fermiums22/LoadingStandBOR0394000/README.md

[README_.md](https://github.com/user-attachments/files/28829557/README_.md)
# LoadingStandBOR0394000

Контроллер нагрузочного стенда для управления магнитопорошковым тормозом на базе STM32G071RB.

* MCU: STM32G071RB
* Board: NUCLEO-G071RB
* IDE: STM32CubeIDE
* Configurator: STM32CubeMX
* Language: C

---

# System requirements

## Hardware

* NUCLEO-G071RB
* Силовая плата BDC-0320-Powerboard 33
* Магнитопорошковый тормоз SKISIA PB-5
* USB кабель для ST-Link
* ПК с STM32CubeIDE

## Software

* STM32CubeIDE
* STM32CubeMX
* ST-Link Utility (опционально)
* Терминал UART (Putty, TeraTerm, RealTerm и т.д.)

---

# Описание проекта

Проект предназначен для управления магнитопорошковым тормозом нагрузочного стенда.

Основной режим работы — регулирование тока тормоза по обратной связи от датчика тока ACS724.

Пользователь задает требуемый ток через UART-консоль, после чего PI-регулятор автоматически подбирает коэффициент заполнения ШИМ для поддержания заданного значения.

Частота контура регулирования составляет 10 кГц.

---

# Основные возможности

* Регулирование тока тормоза
* Ручное управление PWM
* PI-регулятор
* Настройка коэффициентов PI через терминал
* Калибровка нуля датчика тока
* Потоковая телеметрия
* Ограничение максимального тока
* Ограничение максимального PWM
* Самодиагностика ADC через VREFINT
* Двухпортовая UART-консоль с историей команд

---

# Используемое оборудование

## Магнитопорошковый тормоз

Модель:

* SKISIA PB-5

Параметры:

| Параметр | Значение |
| --- | --- |
| Напряжение | 24 В |
| Ток | 2.15 А |
| Мощность | 51.5 Вт  |

---

## Датчик тока

Для измерения тока используется:

* ACS724KMATR-12AB-T

Измеренный ток используется как обратная связь PI-регулятора.

---

## Силовая часть

Основные компоненты силовой платы:

### Драйвер затвора

* UCC23313

### Силовой транзистор

* WSPW20N60C3 (SiC MOSFET)

### Датчик тока

* ACS724KMATR-12AB-T

---

# Архитектура системы

Силовая часть включена низковольтным ключом по минусу. Датчик тока стоит в
силовой цепи последовательно с катушкой, поэтому он измеряет реальный ток всей
петли: длинные провода, катушка и сам датчик находятся внутри одного
непрерывного токового контура.

```text
+24V ──[провод]── Катушка ──[провод]── Датчик тока ── Y ──[MOSFET]── GND
  ▲                                                        │
  └────────────────────── D_fw (Y -> +24V) ────────────────┘
```

```text
Уставка тока
      │
      ▼
PI-регулятор 10 кГц
      │
      ▼
TIM2 PWM
      │
      ├── PA5 -> UCC23313 -> MOSFET
      │
      └── PA1 -> зеркало PWM для осциллографа
                         │
                         ▼
+24V -> провода -> PB-5 -> провода -> ACS724 -> MOSFET -> GND
                         │
                         ▼
                    PA0 / ADC
                         │
                         └── обратная связь по току
```

Особенности силовой петли:

* Провода, катушка и датчик несут один и тот же непрерывный ток; провода тихие,
  датчик читает ток непрерывно.
* Энергия катушки возвращается через длинные провода и диод свободного хода
  `D_fw` в точку `+24V`. Из-за индуктивности проводов возможны пики на
  транзисторе, поэтому нужен аккуратный силовой монтаж и снаббер/ограничение
  перенапряжения при необходимости.

---

# Тактирование

Контроллер использует внешний кварцевый резонатор ABM3-8.000MHZ-D2Y-T,
запаянный на NUCLEO-G071RB.

MCO от ST-Link отключен. Это сделано специально: при коммутации силового
транзистора помехи раньше могли приводить к отваливанию ST-Link, а локальный HSE
кварц на плате Nucleo делает тактирование независимым от ST-Link.

## Источник тактирования

```
HSE = 8 MHz

```

Подключение:

| Вывод | Назначение  |
| ----- | --- |
| PF0 | RCC_OSC_IN  |
| PF1 | RCC_OSC_OUT |

Параметры PLL:

| Параметр | Значение |
| --- | --- |
| PLL Source | HSE |
| PLLM | 1 |
| PLLN | 16 |
| PLLR | 2 |

Расчет:

```text
8 MHz × 16 / 2 = 64 MHz

```

Итоговые частоты:

| Clock  | Value  |
| --- | --- |
| SYSCLK | 64 MHz |
| HCLK | 64 MHz |
| PCLK | 64 MHz |

---

# Подключение контроллера

Контроллер выполнен на базе платы NUCLEO-G071RB.

Питание Nucleo берется с силовой платы: на плате NUCLEO-G071RB установлена
перемычка питания `VIN`, на `VIN` приходит `+12V` с силовой платы. USB/ST-Link
используется для прошивки и отладки, но не является основным источником питания
контроллера в рабочем стенде.

Связь с силовой платой:

| Сигнал | Вывод STM32 | Назначение |
| --- | --- | --- |
| CUR | PA0 | Измерение тока ACS724 |
| PWM | PA5 | Управление силовым каскадом |
| PWM_MON| PA1 | Зеркало PWM для осциллографа|
| USART2_TX | PA2 | ST-Link VCP / отладочная консоль TX |
| USART2_RX | PA3 | ST-Link VCP / отладочная консоль RX |
| USART1_TX | PC4 | Задел под Raspberry Pi TX |
| USART1_RX | PC5 | Задел под Raspberry Pi RX |
| SWDIO  | PA13 | Отладка |
| SWCLK  | PA14 | Отладка |
| +12V | VIN | Питание Nucleo от силовой платы |
| GND | GND | Общий провод |

---

## Сигнал CUR

CUR подключен к выходу датчика тока ACS724.

Цепочка сигнала:

```
+24V -> провода -> PB-5 -> провода -> ACS724 -> MOSFET -> GND
                                │
                                ▼
                              CUR
                                │
                                ▼
                            PA0 (ADC1)

```

---

## Сигнал TORQUE / датчик момента T22

Временная макетная схема входа для датчика момента `HBM/HBK T22 50 Nm`.

Вход STM32:

| Сигнал | Вывод STM32 | Канал ADC |
| --- | --- | --- |
| TORQUE | PB1 / A3 | ADC1_IN9  |

Масштаб датчика, используемый в прошивке:

```text
T22 50 Nm voltage output: +/-5 V = +/-50 Nm
Sensor scale:              10 Nm/V
```

Питание аналоговой макетки:

```text
LD1117 OUT 3.3V -> MCP6002 pin 8
GND              -> MCP6002 pin 4

LD1117 input:   10 uF + 100 nF to GND
LD1117 output:  10 uF + 100 nF to GND
MCP6002 supply: 100 nF between pin 8 and pin 4
```

ОУ A в `MCP6002` делает опорную середину:

```text
3.3V --10k--+--10k-- GND
            |
          INA+ pin 3

OUTA pin 1 -> INA- pin 2

OUTA = about 1.65 V reference
100 nF from OUTA / 1.65 V point to GND
```

ОУ B буферизует смещенный сигнал датчика момента.
Текущая макетная схема:

```text
T22 signal --100k--+--> INB+ pin 5
                   |
                  33k
                   |
              OUTA 1.65 V

OUTB pin 7 -> INB- pin 6
OUTB pin 7 --100R-- PB1 / A3 / ADC1_IN9
```

Собранный вариант для входного диапазона около `+/-3 V`:

```text
Replace the 33k resistor from INB+ to OUTA/1.65V with 54.9k.
On the breadboard it is built as 51k + 3.9k in series.

T22 signal --100k--+--> INB+ pin 5
                   |
                 51k
                   |
                 3.9k
                   |
              OUTA 1.65 V
```

С резисторами `100k` и `54.9k` (`51k + 3.9k` последовательно):

```text
Vpb1 = (54.9 / (100 + 54.9)) * Vt22 + (100 / (100 + 54.9)) * 1.65

Vt22 = -3 V -> Vpb1 ~= 0.00 V
Vt22 =  0 V -> Vpb1 ~= 1.065 V
Vt22 = +3 V -> Vpb1 ~= 2.13 V

ADC sensitivity ~= 35.44 mV/Nm
```

Примечание: пассивный смещенный делитель не использует весь диапазон ADC
`0..3.3 V` симметрично вокруг `1.65 V`. Для красивого отображения
`+/-3 V` примерно в `0.15..3.15 V` нужен активный сумматор/инвертор на ОУ,
а не только замена одного резистора.

---

## Сигнал PWM

PWM формируется таймером TIM2.

Цепочка сигнала:

```
TIM2
  │
  ▼
PA5
  │
  ▼
PWM
  │
  ▼
UCC23313
  │
  ▼
MOSFET
  │
  ▼
нижний ключ силовой цепи

PA1 используется как PWM_MON — дублирующий сигнал для осциллографа.

```

---

# Структура проекта

```text
.
├── Core
│   ├── Inc
│   └── Src
│       ├── main.c
│       ├── control.c
│       ├── console.c
│       └── cmd.c
│
├── Drivers
│
├── tools
│   ├── uart_bridge.py        # serial <-> TCP мост (на Pi) для Wi-Fi доступа
│   ├── uart-bridge.service   # systemd-автозапуск моста после smart-wifi
│   ├── smart-wifi.sh         # копия Pi-скрипта точки доступа (другой разраб)
│   └── console.ps1
│
├── flash_wifi.bat            # сборка прошивки + прошивка по сети через Pi
├── pi_flash.sh               # помощник openocd на Pi (для flash_wifi.bat)
├── LoadingStandBOR0394000.ioc
├── STM32G071RBTX_FLASH.ld
└── README.md

```

---

# Архитектура ПО

```
main.c
 │
 ├── initialization
 │
 ├── control.c
 │     ├── PI regulator
 │     ├── ADC processing
 │     └── PWM control
 │
 ├── console.c
 │     └── UART terminal
 │
 └── cmd.c
       └── command parser

```

---

# Режимы работы

## Current Control Mode

Основной режим работы.

Пользователь задает требуемый ток:

```
set_i <mA>

```

После этого PI-регулятор автоматически поддерживает заданное значение тока.
Старая команда `set <mA>` оставлена как синоним.

---

## Torque Control Mode

Режим регулирования момента работает внешним контуром поверх контура тока:

```text
set_m <Nm>
```

Тормоз создает тормозной момент в обе стороны вращения, поэтому контур момента
регулирует модуль измеренного момента:

```text
error = set_M - abs(M_measured)
```

Подписанный момент `M_measured` остается в телеметрии, чтобы видеть направление
вращения/нагрузки, но регулятор использует `abs(M_measured)`.

### Диссипативный тормоз: детектор направления + feedforward

Тормоз только поглощает момент: измеримый момент существует только когда вал
реально вращают. Датчика скорости нет, поэтому **знак отфильтрованного момента =
направление, в которое давит привод**. Контур момента — машина состояний:

* **ARMED** (`dir=0`, `|M|` ниже порога `Ton`, с дебаунсом) — на тормоз подается
  только табличный feedforward-ток `I_ff(setM)`, интегратор заморожен. Это
  убирает «разнос» (накрутку тока до `imax`), когда нагрузки/мощности нет.
* **HOLD** (`dir=±1`, `|M|` выше `Ton`) — PID подстраивает ток вокруг feedforward:
  `I = I_ff + Kp*(setM-|M|) + интеграл`. Переход ARMED→HOLD бесшовный.
* Реверс проходит через зону `|M|<Toff` → автоматически ре-арм через ARMED.

Параметры детектора и таблица feedforward:

```text
det [Ton] [Toff] [deb]   - пороги детектора [Нм] и дебаунс [отсчётов]
ff                       - показать таблицу I(T)
ff <Nm> <mA>             - добавить/заменить точку таблицы
ff def | ff clear        - дефолтная линия (0,0)..(mmax,imax) | очистить
```

Таблицу `I(T)` нужно откалибровать на стенде (вращая вал, подбирая ток под момент).

Параметры внешнего контура:

```text
mkp [value]  - P gain, mA/Nm
mki [value]  - I gain, mA/(Nm*s)
mkd [value]  - D damping, mA/Nm/sample
mmax <Nm>    - max torque setpoint
```

Текущие предварительные дефолты:

```text
mkp = 35
mki = 120
mkd = 0
mmax = 50 Nm
```

Параметры, установленные через консоль, сохраняются в TAMP backup-регистрах:

```text
kp, ki
set_i <mA>
imax, dmax
mkp, mki, mkd
mmax
```

Они восстанавливаются после reset. При полной потере питания сохранятся только
если backup-домен MCU остается запитанным.

---

## PWM Mode

Ручное управление PWM.

```
pwm <0..100>

```

В этом режиме регулятор отключается.

---

# PI-регулятор

Частота регулирования:

```
10 kHz

```

Настраиваемые параметры:

```
Kp
Ki

```

Изменение коэффициентов возможно во время работы через терминал.

---

# Консоль управления

В проекте включены два UART-порта. Это сделано с заделом под подключение
Raspberry Pi: можно оставить ST-Link VCP для отладки с ПК и параллельно
подключить внешний управляющий контроллер к USART1.

Оба порта работают как одна общая консоль управления:

* команды принимаются с обоих UART;
* ответы на команды идут в тот UART, откуда пришла команда;
* глобальные сообщения и сообщения кнопки могут зеркалиться на оба UART;
* потоковая телеметрия и история команд ведутся независимо для каждого порта.

Параметры подключения:

```
921600 baud
8N1

```

| Порт | Выводы STM32 | Назначение |
| --- | --- | --- |
| USART2 | PA2 / PA3 | ST-Link VCP, терминал на ПК |
| USART1 | PC4 / PC5 | Задел под Raspberry Pi или внешний контроллер |

После подключения отображается:

```
===================================
  BORK Loading Stand BOR0394000
  PI current control @ 10 kHz
===================================

Type 'help'.

```

---

## Общие команды

Команды нечувствительны к регистру. Для некоторых команд с числовым аргументом
можно писать аргумент слитно: например `pwm10`.

| Команда | Аргументы | Описание |
| --- | --- | --- |
| `help` | - | список команд |
| `logo` | - | заставка BORK |
| `status` | - | текущее состояние, измерения и настройки |
| `reset` | - | перезагрузка MCU |
| `reboot` | - | перезагрузка MCU |

---

## Управление выходом

| Команда | Аргументы | Описание |
| --- | --- | --- |
| `pwm` | `<0..100>` | ручной PWM, отключает регуляторы |
| `vt` | `on` | включает режим регулирования тока с текущей уставкой |
| `vt` | `off` | отключает выход |
| `led` | `on` | ручной PWM 50% |
| `led` | `off` | отключает выход |
| `led` | `toggle` | переключает 50% PWM / OFF |

---

## Управление током

| Команда | Аргументы | Описание |
| --- | --- | --- |
| `set_i` | `<mA>` | уставка тока, включает контур тока |
| `set` | `<mA>` | синоним `set_i` |

`set_i` ограничивается параметром `imax`.

---

## Управление моментом

| Команда | Аргументы | Описание |
| --- | --- | --- |
| `set_m` | `<Nm>` | уставка момента, включает внешний контур момента поверх контура тока |
| `det` | `[Ton] [Toff] [deb]` | пороги детектора направления [Нм] + дебаунс; без аргументов — печать |
| `ff` | `[Nm mA] / def / clear` | таблица feedforward `I(T)`: добавить точку / дефолт / очистить |

Контур момента регулирует `abs(M)`, потому что тормоз создает тормозной момент
одинаково в обе стороны вращения. `set_m` ограничивается параметром `mmax`.
Подробнее о детекторе направления и feedforward — в разделе «Torque Control Mode».

---

## Коэффициенты регуляторов

Если аргумент не указан, команда просто печатает текущее значение.

| Команда | Аргументы | Описание |
| --- | --- | --- |
| `kp` | `[value]` | P коэффициент внутреннего контура тока |
| `ki` | `[value]` | I коэффициент внутреннего контура тока |
| `mkp` | `[value]` | P коэффициент внешнего контура момента, `mA/Nm` |
| `mki` | `[value]` | I коэффициент внешнего контура момента, `mA/(Nm*s)` |
| `mkd` | `[value]` | D демпфирование внешнего контура момента, `mA/Nm/sample` |

---

## Ограничения

| Команда | Аргументы  | Описание |
| --- | --- | --- |
| `imax`  | `<mA>` | максимум уставки тока и максимум тока, который может запросить контур момента |
| `mmax`  | `<Nm>` | максимум уставки момента |
| `dmax`  | `<0..100>` | максимум PWM duty, последняя защита силового выхода |

`imax` ограничивает максимальную уставку тока и максимальный ток, который может
запросить внешний контур момента. `dmax` ограничивает максимальный коэффициент
заполнения PWM как последнюю защиту силового выхода.

---

## Калибровка

| Команда | Аргументы | Описание |
| --- | --- | --- |
| `cal` | - | повторная калибровка нуля тока и момента, выход OFF |
| `vref`  | `[N]` | ADC self-check по внутреннему VREFINT, `N=1..4096` |
| `ain` | `[N]` | измерить A3/PB1 относительно VREFINT, `N=1..4096` |

---

## Диагностика ADC/PWM

| Команда | Аргументы | Описание |
| --- | --- | --- |
| `chan`  | `pa0` / `pb1`  | отладочный выбор отображаемого live-канала; рабочий ADC сканирует PA0+PB1 |
| `trig`  | `[cnt]` | задержка/опережение точки выборки ADC в счетах TIM2 |
| `flt` | `[raw] [mA]` | окна фильтра: raw ADC и фильтр тока/момента, например `flt 16 64` |
| `cpu` | - | длительность ADC ISR и пиковая нагрузка, после вывода сбрасывает максимум |

---

## Телеметрия

| Команда | Аргументы | Описание |
| --- | --- | --- |
| `stream`  | `on [Hz]` | общий поток `DATA,...` |
| `stream`  | `off` | выключить общий поток |
| `stream`  | `m [on] [Hz]` | поток только момента |
| `stream`  | `m off` | выключить поток момента |
| `streamA` | `on [Hz]` | поток только тока в амперах |
| `streamA` | `off` | выключить поток тока |
| `streamM` | `on [Hz]` | поток только момента |
| `streamM` | `off` | выключить поток момента |
| `M` | - | напечатать момент один раз |
| `M` | `[Hz]` | включить поток момента с частотой `Hz` |
| `M` | `on [Hz]` | включить поток момента |
| `M` | `off` | выключить поток момента |
| `moment`  | как `M` | синоним `M` |
| `torque`  | как `M` | синоним `M` |
| `rate` | `<ms>` | задать период активного потока в миллисекундах |

Для `[Hz]` допустим диапазон `1..1000`. В одном терминале активен только один
тип потока: общий, ток или момент. В разных UART-консолях потоки независимы.
`Ctrl+C` или `Ctrl+Z` останавливает поток текущей консоли.

---

# Формат телеметрии

Общий поток:

```
DATA,<tick_ms>,<set_mA>,<I_mA>,<setM_mNm>,<M_mNm>,<duty%>,<dir>

```

| Поле | Единицы | Описание |
| --- | --- | --- |
| `tick_ms`  | мс | `HAL_GetTick()`, монотонное время устройства |
| `set_mA` | мА | текущая уставка тока (для контура момента — выход контура) |
| `I_mA` | мА | измеренный ток (знаковый) |
| `setM_mNm` | мН·м | уставка момента ×1000 (милли-Н·м) |
| `M_mNm` | мН·м | измеренный момент ×1000, знаковый |
| `duty%` | % | коэффициент заполнения PWM |
| `dir` | -1/0/+1 | направление: -1 NEG, 0 ARMED (нет нагрузки), +1 POS |

Момент передается в милли-Н·м (целые числа), чтобы график сохранял разрешение
около нуля. Для перевода в Н·м делить на 1000.

Пример (`set_m 2`, вал проворачивают рукой):

```
DATA,100,0,3,2000,-8,0,0
DATA,200,250,248,2000,1850,12,1
DATA,300,250,251,2000,2010,12,1

```

Поток тока `streamA`:

```text
 0.5000 A
```

Поток момента `streamM` / `M <Hz>`:

```text
 12.345 Nm
```

---

# Удалённое управление и графики по Wi-Fi (serial → TCP)

Тот же протокол консоли (команды + поток `DATA,...`) доступен по сети. Стенд
подключается к одноплатнику (Raspberry Pi CM4) по `USART1`, а на Pi поднимается
прозрачный мост **serial ↔ TCP**. Любой клиент в сети открывает TCP-сокет и
работает ровно как с UART: шлёт строки-команды и читает телеметрию. Отдельное
ПК-приложение не требуется.

## Физическое подключение к Pi

`USART1` стенда (`PC4 = TX`, `PC5 = RX`, 921600 8N1) — к UART одноплатника.
Пример для CM4 (UART5 на 40-pin разъёме, перекрёст TX↔RX, общий GND):

| Pi (CM4) | → | STM32 |
| --- | --- | --- |
| GPIO12 / pin 32 TXD5 | → | PC5 (USART1 RX) |
| GPIO13 / pin 33 RXD5 | → | PC4 (USART1 TX) |
| GND / pin 34 | — | GND |

UART5 включается в `/boot/firmware/config.txt`: `dtoverlay=uart5` → `/dev/ttyAMA5`.

## Мост на Pi

`tools/uart_bridge.py` пробрасывает `/dev/ttyAMA5` ↔ `TCP 0.0.0.0:5555`
(чистый stdlib Python 3, без зависимостей):

```bash
python3 uart_bridge.py [device] [baud] [tcp_port]    # по умолчанию /dev/ttyAMA5 921600 5555
```

Автозапуск — через `tools/uart-bridge.service` (systemd), упорядочен
`After=smart-wifi.service`, т.е. поднимается после самописного скрипта точки
доступа (`tools/smart-wifi.sh`, оригинал — `/usr/local/bin/smart-wifi.sh`):

```bash
sudo cp uart-bridge.service /etc/systemd/system/
sudo systemctl enable --now uart-bridge
```

## Протокол поверх TCP

После `connect(<pi-ip>, 5555)` канал полностью прозрачен — это байты UART-консоли:

* **команда** — ASCII-строка с завершающим `\r` (например `set_m 2\r`, `vt off\r`);
* **график момента** — послать `stream on 50\r` и парсить строки `DATA,...`
  (см. «Формат телеметрии»); момент в полях `setM_mNm` / `M_mNm` (мН·м, делить на 1000);
* **только момент** — `streamM on 50\r`, строки вида ` 12.345 Nm`;
* **управление** — `set_m <Nm>`, `set_i <mA>`, `pwm <0..100>`, `vt off`, `cal`, и т.д.;
* **остановить поток** — `stream off\r` (или `Ctrl+C` = байт `0x03`).

Минимальный пример (Python, снять график момента 50 Гц):

```python
import socket, time
s = socket.create_connection(("192.168.0.104", 5555))
s.sendall(b"stream on 50\r")              # запросить поток DATA
time.sleep(5)                              # ... читать и парсить ...
buf = s.recv(65536).decode("ascii", "replace")
for line in buf.splitlines():
    if line.startswith("DATA,"):
        f = line.split(",")
        t_ms   = int(f[1])
        I_mA   = int(f[3])
        M_Nm   = int(f[5]) / 1000.0        # измеренный момент
        dir_   = int(f[7])                 # -1/0/+1
s.sendall(b"stream off\r")
s.close()
```

Управление приводом-комбайном и стендом ведется независимо: комбайн — по своему
каналу, стенд — по этому TCP-порту; параллельные графики строит клиент.

---

# Команда status

Команда отображает:

* текущий режим работы;
* заданный ток;
* измеренный ток;
* заданный момент;
* подписанный измеренный момент;
* модуль измеренного момента;
* коэффициент заполнения PWM;
* коэффициенты контуров тока и момента;
* ограничения безопасности;
* raw ADC и напряжения `PA0` / `PB1`;
* текущую точку выборки ADC.

---

# Калибровка

Команда:

```
cal

```

выполняет повторную калибровку нуля датчика тока ACS724 и нуля датчика момента
T22. На время калибровки выход выключается.

Рекомендуется выполнять после включения питания и при отсутствии тока через тормоз.

---

# Сборка проекта

1. Открыть проект в STM32CubeIDE.
2. Открыть файл `LoadingStandBOR0394000.ioc`.
3. При необходимости выполнить Generate Code.
4. Выполнить Build Project.
5. Прошить устройство через ST-Link.

---

# ToDo

* Автоматическая калибровка
* Логирование результатов испытаний
* ПК-приложение для настройки и мониторинга

---

# License
