fermiums22/LoadingStandBOR0394000/Core/Src/main.c

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
/* Includes ------------------------------------------------------------------*/
#include "main.h"

/* USER CODE BEGIN Includes */
#include "console.h"
#include "control.h"
#include "cmd.h"
#include <stdio.h>
/* USER CODE END Includes */

ADC_HandleTypeDef hadc1;
DMA_HandleTypeDef hdma_adc1;

TIM_HandleTypeDef htim2;

UART_HandleTypeDef huart1;
UART_HandleTypeDef huart2;
DMA_HandleTypeDef hdma_usart1_rx;
DMA_HandleTypeDef hdma_usart2_rx;

void SystemClock_Config(void);
static void MX_GPIO_Init(void);
static void MX_DMA_Init(void);
static void MX_USART2_UART_Init(void);
static void MX_ADC1_Init(void);
static void MX_TIM2_Init(void);
static void MX_USART1_UART_Init(void);
/* USER CODE BEGIN PFP */
void App_Init(void);
void App_Process(void);
/* USER CODE END PFP */

/**
  * @brief  The application entry point.
  * @retval int
  */
int main(void)
{

  /* MCU Configuration--------------------------------------------------------*/

  /* Reset of all peripherals, Initializes the Flash interface and the Systick. */
  HAL_Init();

  /* Configure the system clock */
  SystemClock_Config();

  /* Initialize all configured peripherals */
  MX_GPIO_Init();
  MX_DMA_Init();
  MX_USART2_UART_Init();
  MX_ADC1_Init();
  MX_TIM2_Init();
  MX_USART1_UART_Init();
  /* USER CODE BEGIN 2 */
  App_Init();
  /* USER CODE END 2 */

  /* Infinite loop */
  /* USER CODE BEGIN WHILE */
  while (1)
  {
    /* USER CODE END WHILE */

    /* USER CODE BEGIN 3 */
    App_Process();   /* inside USER CODE 3 so CubeMX regeneration keeps it */
  }
  /* USER CODE END 3 */
}

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
/* USER CODE BEGIN 4 */

/* Application glue: wires the console, command parser and PI regulator. */
void App_Init(void)
{
  Reg_Init();        /* ADC calibration, 10 kHz PWM, timer-triggered ADC */
  Console_Init();    /* USART2 RX DMA ring + IRQ-driven TX ring          */
  Cmd_Init();

  Cmd_Banner();    /* BORK welcome logo on every boot/reset */
}

void App_Process(void)
{
  uint8_t c; int port;
  while (Console_ReadByte(&c, &port)) Cmd_FeedByte(port, (char)c);
  Cmd_StreamTask();

  /* B1 button (PC13, active-low): OFF + increasing TORQUE setpoints (1..25 Nm).
     Torque mode arms the feedforward and only closes the PID loop once the shaft
     is actually driven (hand-rotated) - so at 0 / no motion it does NOT run away.*/
  static const struct { float Nm; const char *name; } seq[] = {
    {  0.0f, "1 OFF"      },
    {  1.0f, "2 M 1 Nm"   },
    {  2.0f, "3 M 2 Nm"   },
    {  3.0f, "4 M 3 Nm"   },
    {  5.0f, "5 M 5 Nm"   },
    {  8.0f, "6 M 8 Nm"   },
    { 12.0f, "7 M 12 Nm"  },
    { 16.0f, "8 M 16 Nm"  },
    { 20.0f, "9 M 20 Nm"  },
    { 25.0f, "10 M 25 Nm" },
  };
  const int NSEQ = (int)(sizeof seq / sizeof seq[0]);

  static int           seq_idx  = 0;            /* current step (0 = OFF at boot) */
  static GPIO_PinState btn_prev = GPIO_PIN_SET;
  static uint32_t      btn_tick = 0;
  GPIO_PinState btn = HAL_GPIO_ReadPin(GPIOC, GPIO_PIN_13);
  if (btn == GPIO_PIN_RESET && btn_prev == GPIO_PIN_SET && (HAL_GetTick() - btn_tick) > 200u)
  {
    btn_tick = HAL_GetTick();
    seq_idx = (seq_idx + 1) % NSEQ;             /* advance to the next state */

    if (seq_idx == 0) Reg_SetMode(OUT_OFF);
    else              Reg_SetTorqueSetpoint_Nm(seq[seq_idx].Nm);

    char b[64];
    snprintf(b, sizeof b, "\r\n[BTN] step %s (of %d)\r\n", seq[seq_idx].name, NSEQ);
    Console_Print(b);
  }
  btn_prev = btn;
}

/* USER CODE END 4 */
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
