fermiums22/LoadingStandBOR0394000/LoadingStandBOR0394000.ioc

Mcu.UserName=STM32G071RBTx
PA0.Signal=ADC1_IN0
PA1.Signal=S_TIM2_CH2
PA13.GPIO_Label=TMS
PA13.Signal=SYS_SWDIO
PA14-BOOT0.GPIO_Label=TCK
PA14-BOOT0.Signal=SYS_SWCLK
PA2.GPIO_Label=USART2_TX [STLK_TX]
PA2.Signal=USART2_TX
PA3.GPIO_Label=USART2_RX [STLK_RX]
PA3.Signal=USART2_RX
PA5.Signal=S_TIM2_CH1_ETR
PA8.Signal=GPIO_Output
PB1.Signal=ADC1_IN9
PC13.GPIO_Label=B1_BUTTON
PC13.Signal=GPIO_Input
PC4.Signal=USART1_TX
PC5.Signal=USART1_RX
