fermiums22/LoadingStandBOR0394000/Core/Inc/main.h

#define B1_BUTTON_Pin GPIO_PIN_13
#define B1_BUTTON_GPIO_Port GPIOC
#define USART2_TX_Pin GPIO_PIN_2
#define USART2_TX_GPIO_Port GPIOA
#define USART2_RX_Pin GPIO_PIN_3
#define USART2_RX_GPIO_Port GPIOA
#define TMS_Pin GPIO_PIN_13
#define TMS_GPIO_Port GPIOA
#define TCK_Pin GPIO_PIN_14
#define TCK_GPIO_Port GPIOA
