fermiums22/LoadingStandBOR0394000/(commit log)

2026-06-10 pwm test
2026-06-11 Add README with project description and usage guide
    Firmware documentation for BOR0394000 loading stand.
    Includes:
    - Hardware overview
    - STM32G071RB configuration
    - Pin mapping
    - Clock tree settings
    - PWM and current control description
    - UART terminal commands
    - Build and flashing instructions
    - Project structure
2026-06-11 Add documentation and current controller changes
2026-06-12 Add torque control and flashing workflow
2026-06-16 Add torque feedforward + direction detector for dissipative brake
    The brake only absorbs torque, so a measured torque exists only when the
    shaft is actually driven. With no speed sensor, the sign of the filtered
    torque is used as the drive direction. OUT_TORQUE is now a state machine:
    - ARMED (|T| below Ton, debounced): hold the table feedforward current
    only, integrator frozen -> no windup to imax when there is no load /
    no power source (fixes the runaway).
    - HOLD (|T| above Ton): PID trims around the feedforward to hold |T|;
    integ carries only the trim, so ARMED->HOLD is bumpless. Reversal
    crosses the |T|<Toff dead-band and re-arms through ZERO.
    Adds a linear I(T) feedforward tab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
    [cmd.c, control.c, control.h, main.c]
2026-06-16 Stream torque/setpoint at milli-Nm resolution + dir field
    The DATA telemetry line printed torque as integer Nm, which hides the
    near-zero behaviour the PC plot needs. Send setM/M as milli-Nm (x1000,
    integer formatting only) and append the direction state (-1/0/+1):
    DATA,<tick_ms>,<set_mA>,<I_mA>,<setM_mNm>,<M_mNm>,<duty%>,<dir>
2026-06-16 Add pc_tool (DriveScope copy) with Load Stand torque tab
    Local copy of tools/pc-tool with a new dockable "Load Stand" tab that
    connects to the loading-stand STM32 over a Pi serial->TCP bridge and
    plots torque (with setpoint/current) alongside the combine's plots.
    - src/loadstand/LoadStandClient.{h,cpp}: TCP client, parses the DATA
    stream into time-series buffers, sends CLI commands (set_m, vt off).
    - src/loadstand/LoadStandTab.cpp: MainUi::drawLoadStand() — connect
    controls, live readout (M/set/I/duty/dir), ImPlot torque graph.
    - Wired as a 9th tab (kNumTabs, kDockTabs, view menu, tab strip).
    - tools/uart_bridge.py + uart-bridge.service: Pi-side serial<->TCP
    bridge for /dev/ttyAMA5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
    [drivescope_scenario.json, drivescope_slcan_debug.json, drivescope_slcan_protocol_probe.json, drivescope_tcp_protocol_probe.json, drivescope_wifi_debug.json]
2026-06-16 Plot loading-stand torque on the main Plots graph (not a separate tab)
    The stand torque now feeds MainUi buffers on the shared plot time base and
    is drawn inside the main "Signals" plot as "stand M [Nm]" (+ optional
    setpoint/current), so the existing ruler, box-zoom, autoscale and signal
    logger all work on it. The Load Stand tab keeps only connection/control
    and series toggles. Samples are pumped each frame in pumpLoadStand() and,
    when the signal logger is active, written to the saved CSV.
2026-06-16 Add build/flash-over-wifi scripts and bridge autostart after AP script
    - build_pc_tool.bat: configure+build DriveScope (MinGW+Ninja) and launch it.
    - flash_wifi.bat + pi_flash.sh: build firmware, scp the .elf to the Pi and
    flash it via openocd over the network (program+verify+reset).
    - uart-bridge.service now ordered After=smart-wifi.service / Wants it, so the
    serial->TCP bridge auto-starts on boot once the self-written AP-fallback
    script (smart-wifi.sh) has settled the network. Service installed+enabled.
    - pc_tool/docs/smart-wifi.sh: reference copy of the Pi's AP-fallback script
    (/usr/local/bin/smart-wifi.sh, written by another dev).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
2026-06-16 Remove pc_tool; document the wire + Wi-Fi protocol in README
    Drop the in-repo DriveScope copy (pc_tool) and its build script. The console
    protocol is now fully documented so any client can talk to the stand without a
    bundled app:
    - updated DATA telemetry format (torque/setpoint in milli-Nm + dir field)
    - added det / ff commands (direction detector + feedforward table) and the
    dissipative-brake ARMED/HOLD description to Torque Control Mode
    - new "Remote control & graphs over Wi-Fi" section: serial->TCP bridge wiring,
    tools/uart_bridge.py + uart-bridge.service autostart (After=smart-wifi),
    and the raw TCP protocol with a minimal Python example
    Bridge/AP helper scripts kept under tools/ (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
    [drivescope_scenario.json, drivescope_slcan_debug.json, drivescope_slcan_protocol_probe.json, drivescope_tcp_protocol_probe.json, drivescope_wifi_debug.json]
